cmdrscotty/Rudder_Pedals/RudderPedal BOM.xlsx

Amount to purchase | Item | Link (if applicable)
1 | M3 M4 M5 screw assortment kit | https://www.amazon.com/dp/B0FGX9JGC5
1 | 8mm shoulder bolt (m6 thread, 30mm long) | https://www.amazon.com/dp/B0DP6ZMZC2
1 | 49e Hall Effect Sensors | https://www.amazon.com/dp/B0CZ6RL4B2
1 | Arduino Pro Micro | https://www.amazon.com/dp/B09C5H78BP
1 | 608-RS ball bearings | https://www.amazon.com/dp/B0B311J3QP
1 | 80mm 1/10 RC shock absorbers | https://www.amazon.com/dp/B0CWHDGLK5
1 | Brass Heat Set inserts | https://www.amazon.com/dp/B0F2N8QY45
2 | M8 x 150mm bolts
2 | M8 nuts
1 | Perfboard PCB | cut to size
