cmdrscotty/Rudder_Pedals/STL/Print 1x of each/L_R_magnet holder_v2.stl

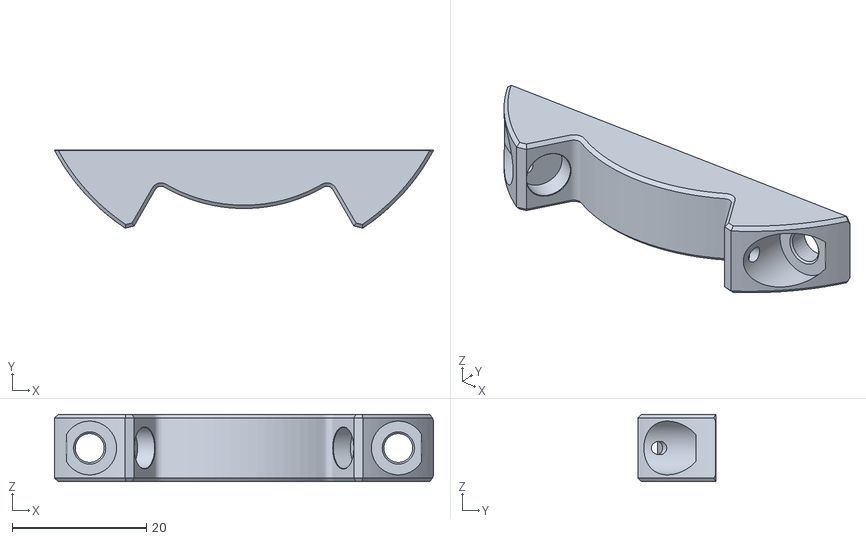
[picture p1: CAD file, 2026-10-14]
STL/Print 1x of each/L_R_magnet holder_v2.stl
56.5 x 11.7 x 10.0
