cmdrscotty/Rudder_Pedals/STL/Print 1x of each/Pedals/HallEffect_CadetPedal_12Degrees_Minimalistic_L.stl

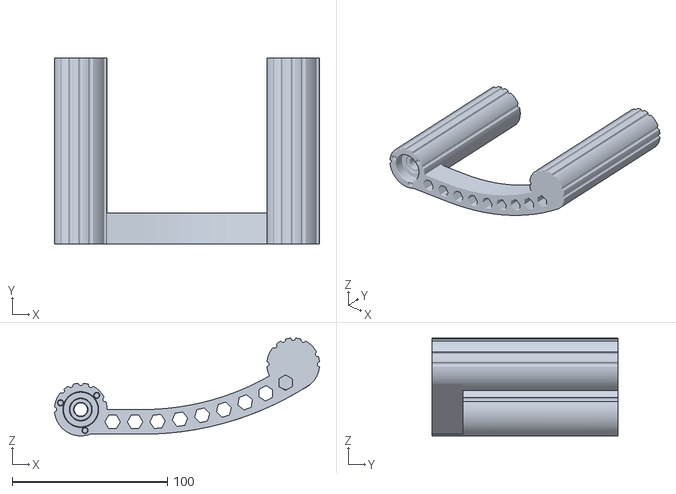
[picture p2: CAD file, 2026-10-14]
STL/Print 1x of each/Pedals/HallEffect_CadetPedal_12Degrees_Minimalistic_L.stl
170.8 x 120.0 x 63.0
