cmdrscotty/Rudder_Pedals/STL/Print 2x of each/Brake sensor v2.stl

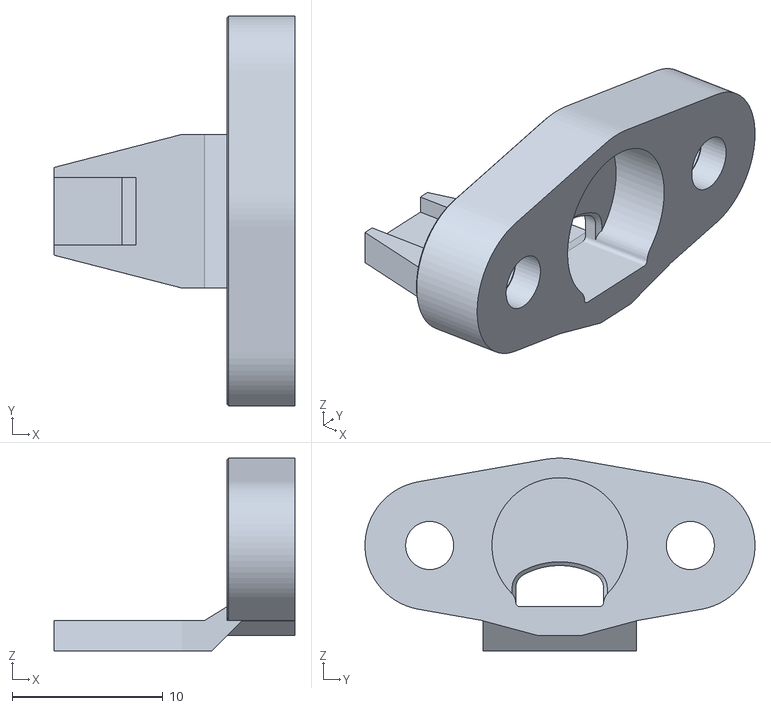
[picture p3: CAD file, 2026-10-14]
STL/Print 2x of each/Brake sensor v2.stl
16.0 x 25.9 x 12.8
