cmdrscotty/Rudder_Pedals/STL/Print 6x of each/Spacer.stl

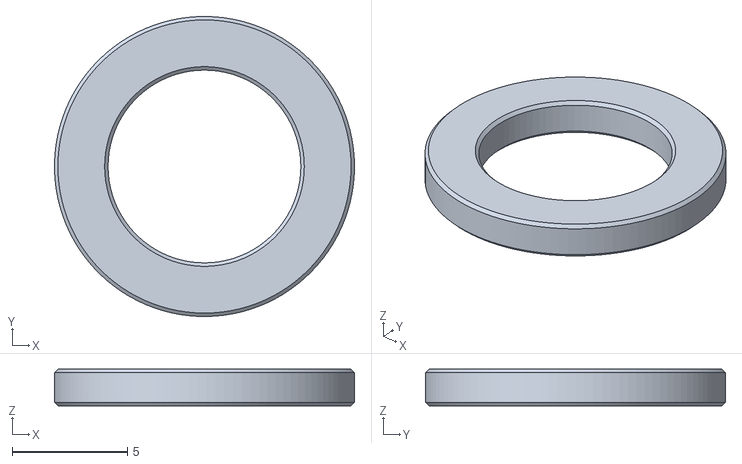
[picture p4: CAD file, 2026-10-14]
STL/Print 6x of each/Spacer.stl
13.0 x 13.0 x 1.59
