cmdrscotty/Rudder_Pedals/STL/Print 1x of each/B_Platform_L.stl

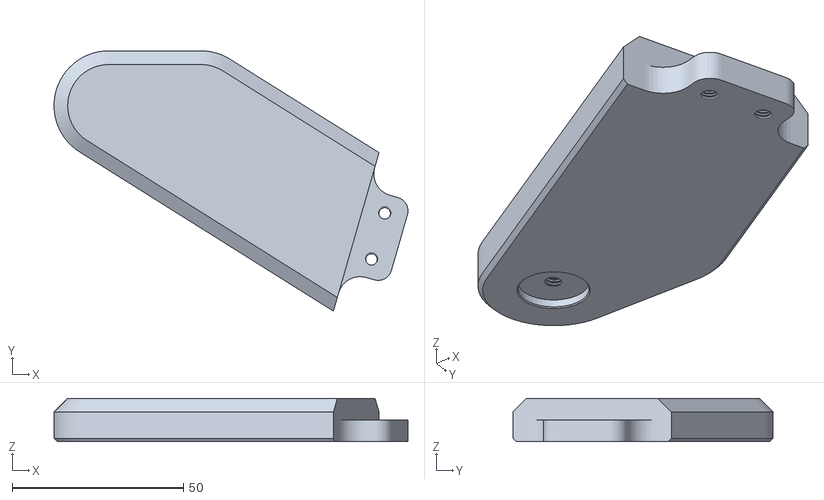
[picture p5: CAD file, 2026-10-14]
STL/Print 1x of each/B_Platform_L.stl
103.4 x 76.0 x 12.7
