cmdrscotty/Rudder_Pedals/STL/Print 1x of each/Pedals/HallEffect_CadetPedal_18Degrees_Minimalistic_R.stl

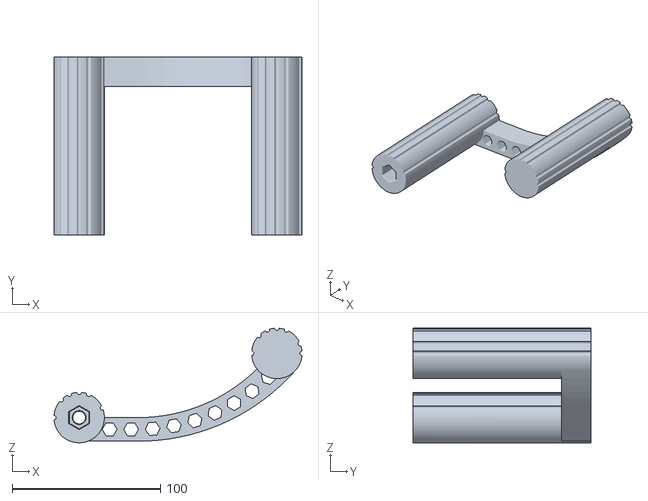
[picture p6: CAD file, 2026-10-14]
STL/Print 1x of each/Pedals/HallEffect_CadetPedal_18Degrees_Minimalistic_R.stl
167.0 x 120.0 x 77.2
