cmdrscotty/Rudder_Pedals/STL/Print 2x of each/Brake_Sensor_Housing_2.stl

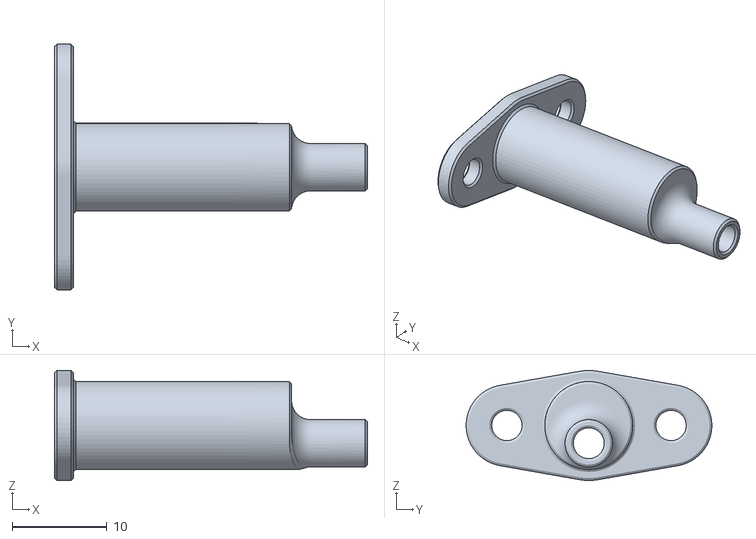
[picture p7: CAD file, 2026-10-14]
STL/Print 2x of each/Brake_Sensor_Housing_2.stl
33.0 x 25.9 x 11.6
