cmdrscotty/Rudder_Pedals/STL/Print 1x of each/R_Pedal_Bracket.stl

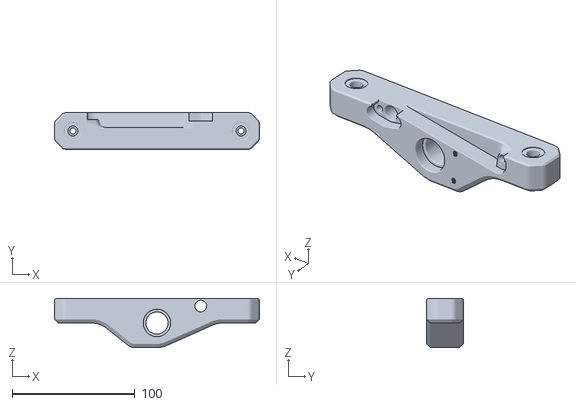
[picture p8: CAD file, 2026-10-14]
STL/Print 1x of each/R_Pedal_Bracket.stl
166.8 x 30.0 x 40.0
