cmdrscotty/Rudder_Pedals/STL/Print 2x of each/Pedal_Spacer.stl

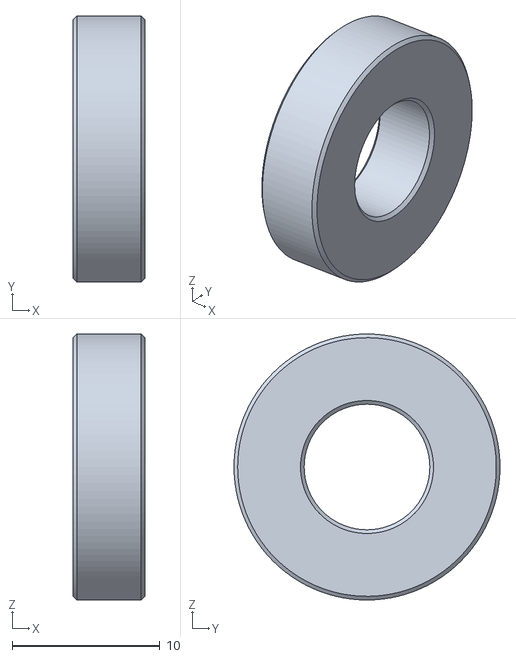
[picture p9: CAD file, 2026-10-14]
STL/Print 2x of each/Pedal_Spacer.stl
4.86 x 18.0 x 18.0
