cmdrscotty/Rudder_Pedals/STL/Print 1x of each/Pedals/HallEffect_CadetPedal_8Degrees_Minimalistic_R.stl

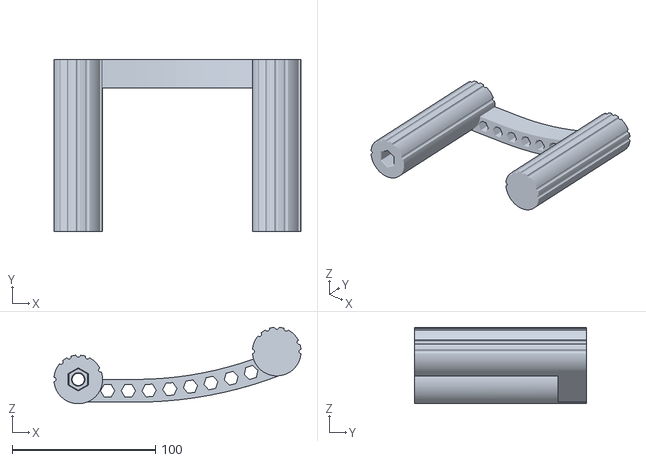
[picture p10: CAD file, 2026-10-14]
STL/Print 1x of each/Pedals/HallEffect_CadetPedal_8Degrees_Minimalistic_R.stl
172.5 x 120.0 x 53.4
