cmdrscotty/Rudder_Pedals/STL/Print 1x of each/TensionArm.stl

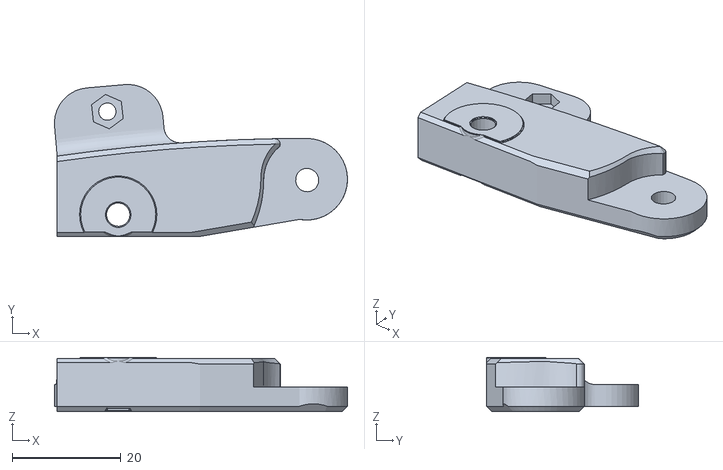
[picture p11: CAD file, 2026-10-14]
STL/Print 1x of each/TensionArm.stl
53.8 x 27.9 x 10.0
