cmdrscotty/Rudder_Pedals/STL/Print 1x of each/Arduino_Holder.stl

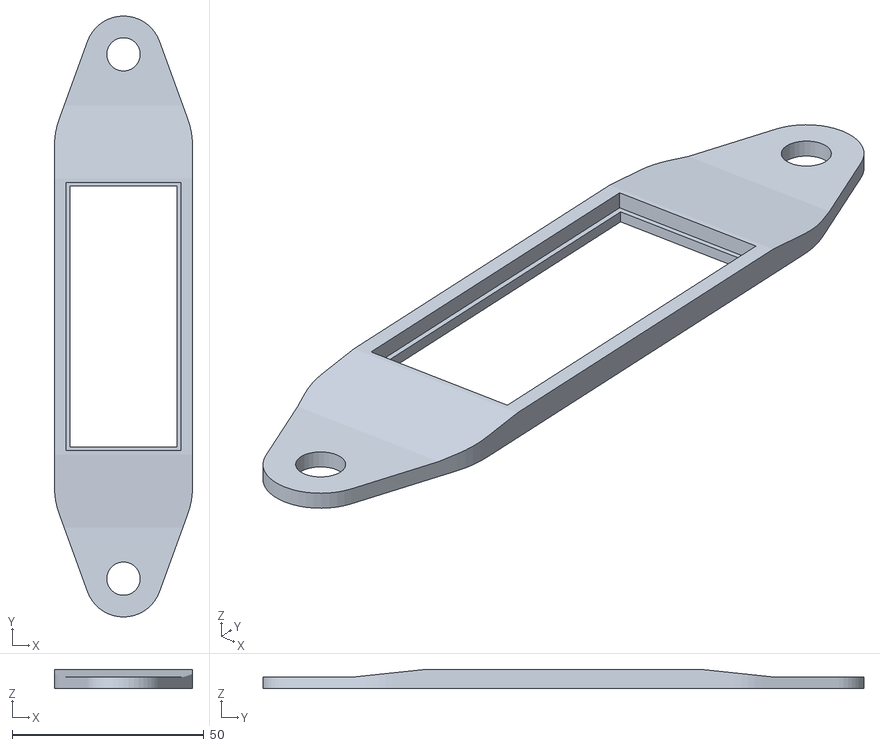
[picture p12: CAD file, 2026-10-14]
STL/Print 1x of each/Arduino_Holder.stl
36.0 x 156.8 x 5.00
