cmdrscotty/Rudder_Pedals/STL/Print 1x of each/Front_Bottom_Bar.stl

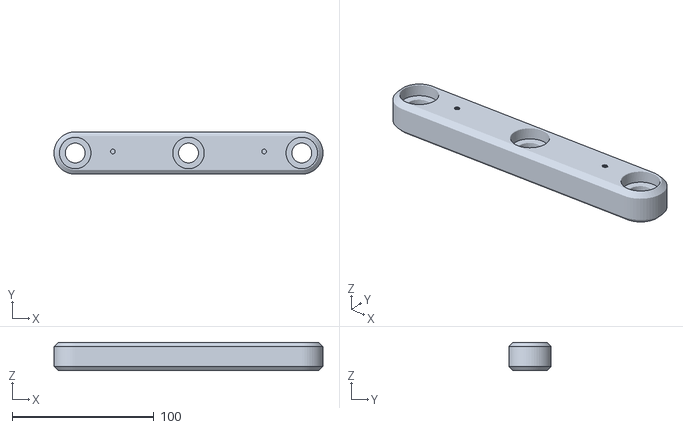
[picture p13: CAD file, 2026-10-14]
STL/Print 1x of each/Front_Bottom_Bar.stl
189.9 x 30.0 x 20.0
