cmdrscotty/Rudder_Pedals/STL/Print 1x of each/Rear_Bottom_Bar.stl

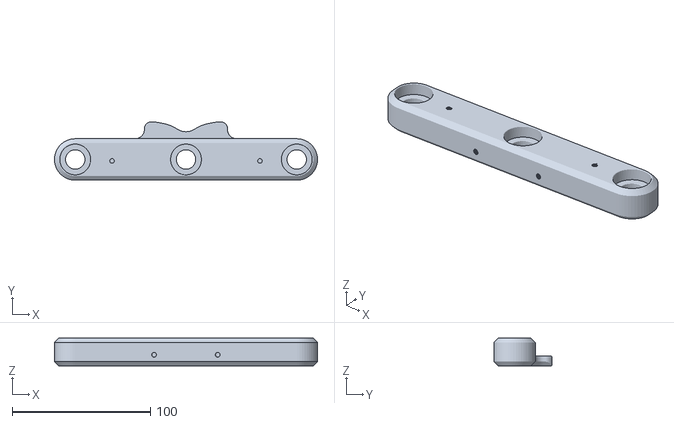
[picture p14: CAD file, 2026-10-14]
STL/Print 1x of each/Rear_Bottom_Bar.stl
189.9 x 42.2 x 20.0
