cmdrscotty/Rudder_Pedals/STL/Print 1x of each/F_Platform_2.stl

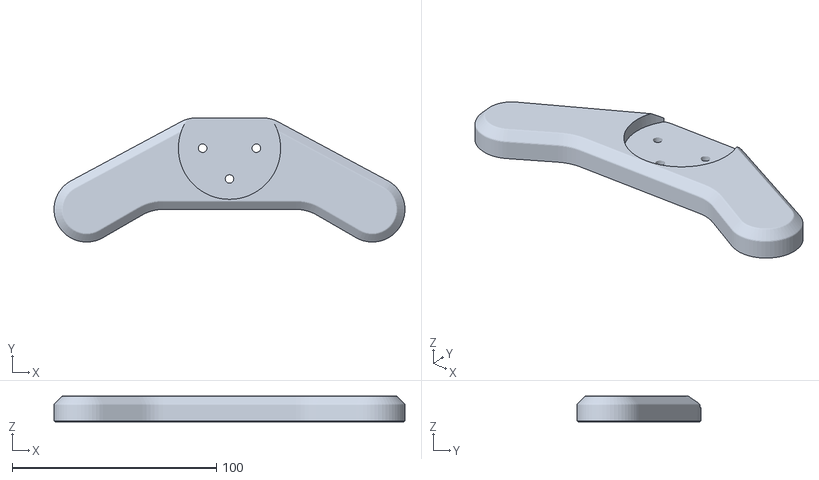
[picture p15: CAD file, 2026-10-14]
STL/Print 1x of each/F_Platform_2.stl
172.0 x 60.8 x 12.7
