cmdrscotty/Rudder_Pedals/STL/Print 1x of each/Bearing_Holder.stl

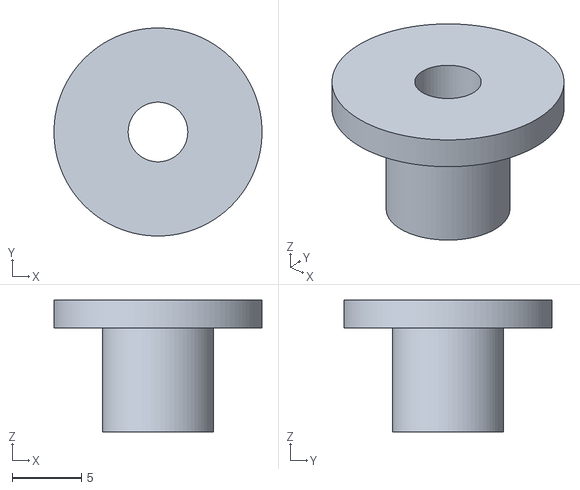
[picture p16: CAD file, 2026-10-14]
STL/Print 1x of each/Bearing_Holder.stl
15.0 x 15.0 x 9.50
