cmdrscotty/Rudder_Pedals/STL/Print 1x of each/L_Pedal_Quadrant.stl

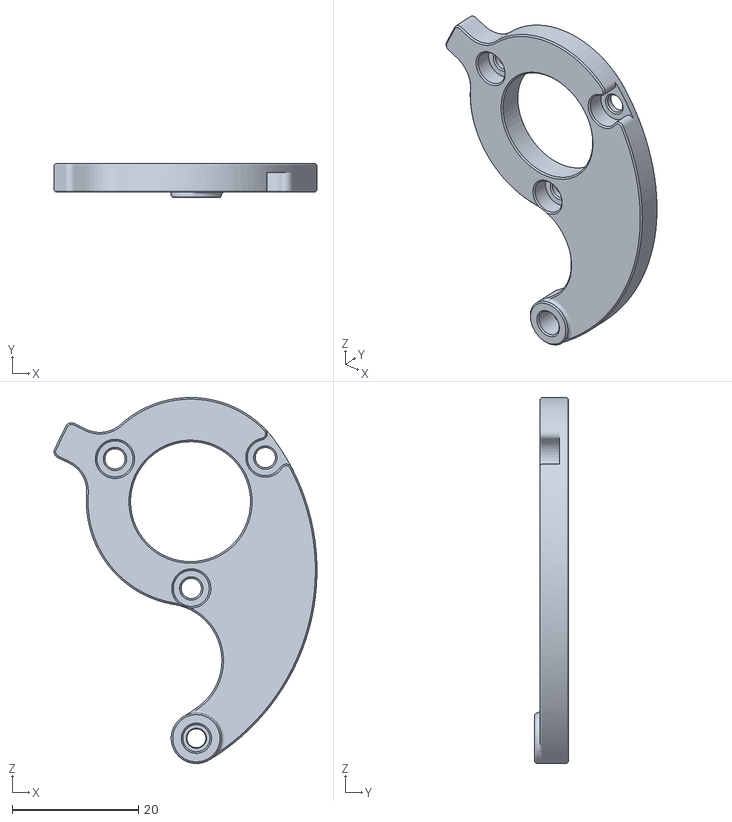
[picture p17: CAD file, 2026-10-14]
STL/Print 1x of each/L_Pedal_Quadrant.stl
41.7 x 5.37 x 58.0
