cmdrscotty/Rudder_Pedals/STL/Print 1x of each/Rudder_Sensor_Body.stl

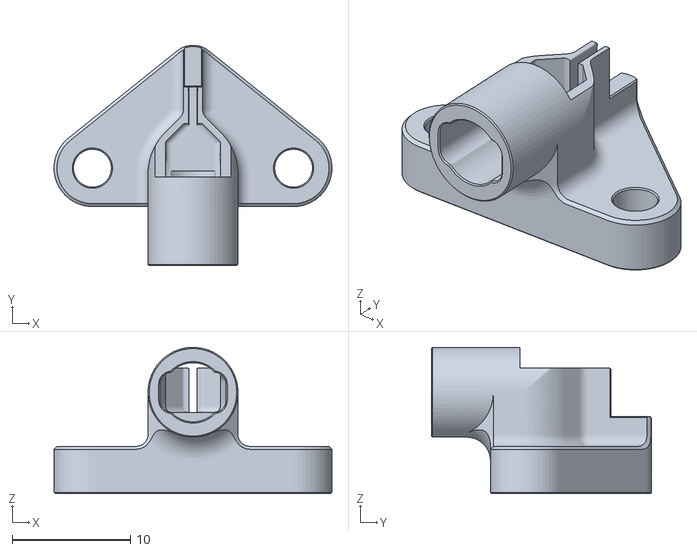
[picture p18: CAD file, 2026-10-14]
STL/Print 1x of each/Rudder_Sensor_Body.stl
23.5 x 18.6 x 12.4
