cmdrscotty/Rudder_Pedals/STL/Print 1x of each/Base.stl

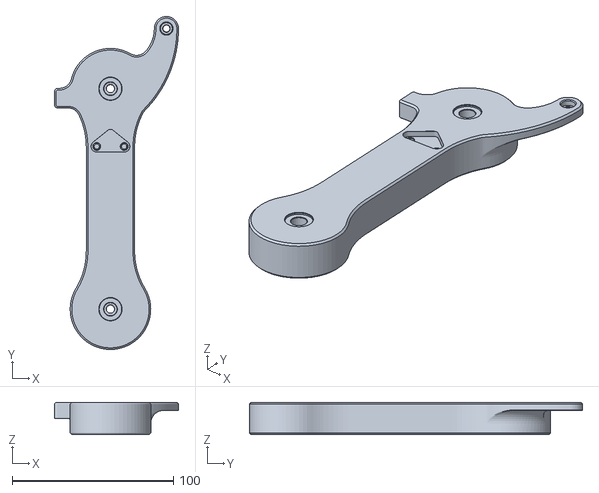
[picture p19: CAD file, 2026-10-14]
STL/Print 1x of each/Base.stl
76.9 x 206.5 x 20.0
