cmdrscotty/Rudder_Pedals/STL/Print 1x of each/Platform.stl

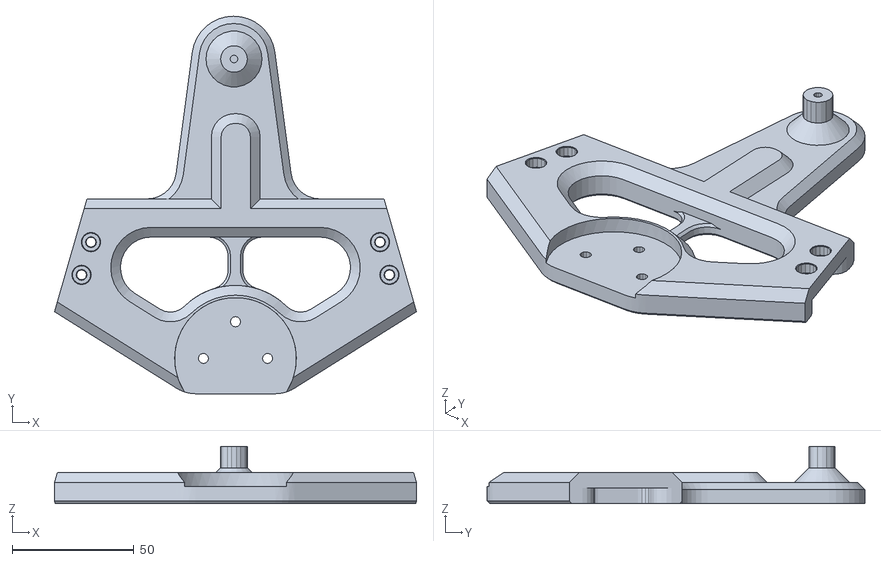
[picture p20: CAD file, 2026-10-14]
STL/Print 1x of each/Platform.stl
148.6 x 155.0 x 23.5
