cmdrscotty/Rudder_Pedals/(list of files, cad)

Other CAD files:
STL/Print 1x of each/Pedals/HallEffect_CadetPedal_12Degrees_Minimalistic_R.stl
STL/Print 1x of each/Pedals/HallEffect_CadetPedal_8Degrees_Minimalistic_L.stl
STL/Print 1x of each/Pedals/HallEffect_CadetPedal_18Degrees_Minimalistic_L.stl
STL/Print 1x of each/L_Pedal_Bracket.stl
STL/Print 1x of each/B_PLatform_R.stl
STL/Print 1x of each/R_Pedal_Quadrant.stl
STL/Print 1x of each/Screw_Knob.stl
