cmdrscotty/Rudder_Pedals/(commit log)

2026-10-14 Bill of Materials
    Bill of Materials
    [RudderPedal BOM.xlsx]
2026-10-14 Update README.md
    added links to the files to print
2026-10-14 Update README.md
    Updated with instructions on assembly and links to 3d print files
2026-10-14 added Arduino code
2026-10-14 Update README.md
    added directions about wiring to the Arduino
2026-10-14 update BOM
    [RudderPedal BOM.xlsx]
2026-10-14 Added STL files, Config files, and updated README.MD
    [Arduino_Holder.stl, B_PLatform_R.stl, B_Platform_L.stl, Base.stl, Bearing_Holder.stl, Brake sensor v2.stl, Brake_Sensor_Housing_2.stl, F_Platform_2.stl]
